HaroldMurcia/Line_Follower/data/slides.pdf

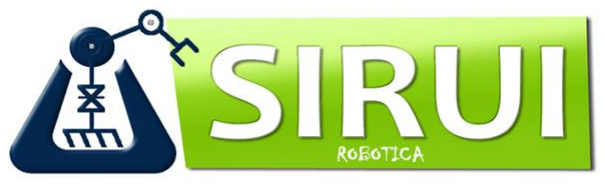
[picture p1: figure]

# DISEÑO E IMPLEMENTACIÓN DE UN ROBOT SEGUIDOR DE LÍNEA DE COMPETENCIA PARA LA CATEGORÍA VELOCISTA

# Autor: Yeison D TAPIERO Director: Harold F MURCIA

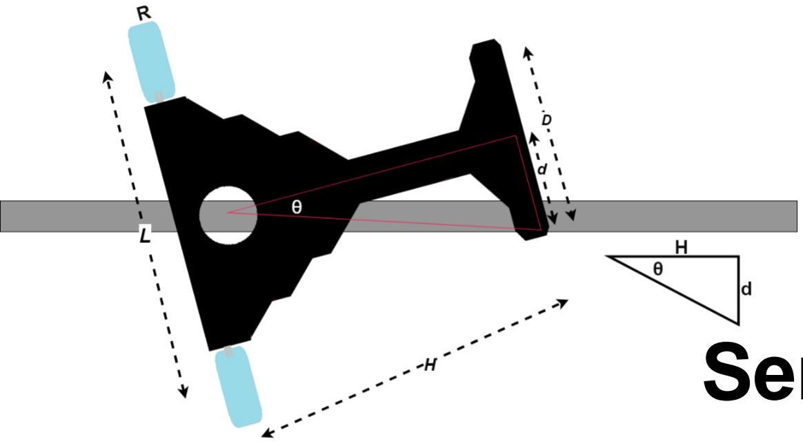
[picture p2: figure]

# Semillero de Investigación: SIRUI Fecha: 15 de Julio de 2019

# Introducción

1

2

3

4

### Planteamiento del Problema

### Objetivos

### Metodología

### Desarrollo

### 5 Resultados

6

### Conclusiones y Trabajo Futuro

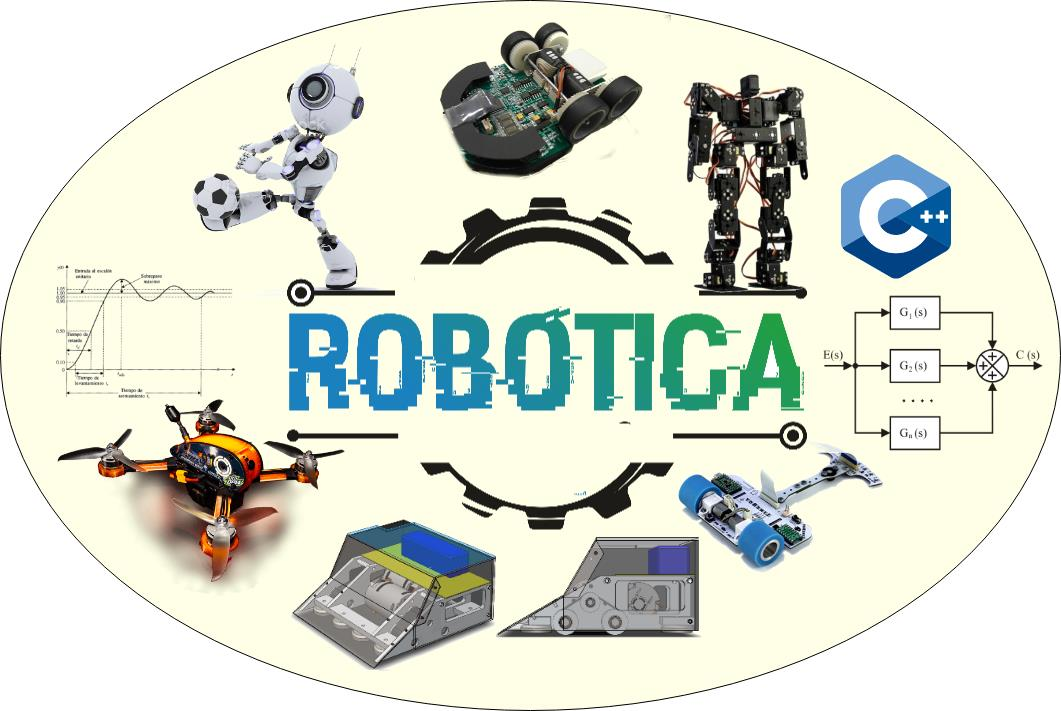
[picture p3: figure]

### La robótica móvil es una de las ramas de la ingeniería que mas avances ha presentado

en | las | últimas | décadas. | Nuevas

### configuraciones mecánicas, estructuras de

control | y | navegación, | desarrollos | en
vehículos | no | tripulados | y | nuevas

### aplicaciones han cambiado la forma en que

conocíamos los sistemas robóticos.

# Planteamiento del Problema

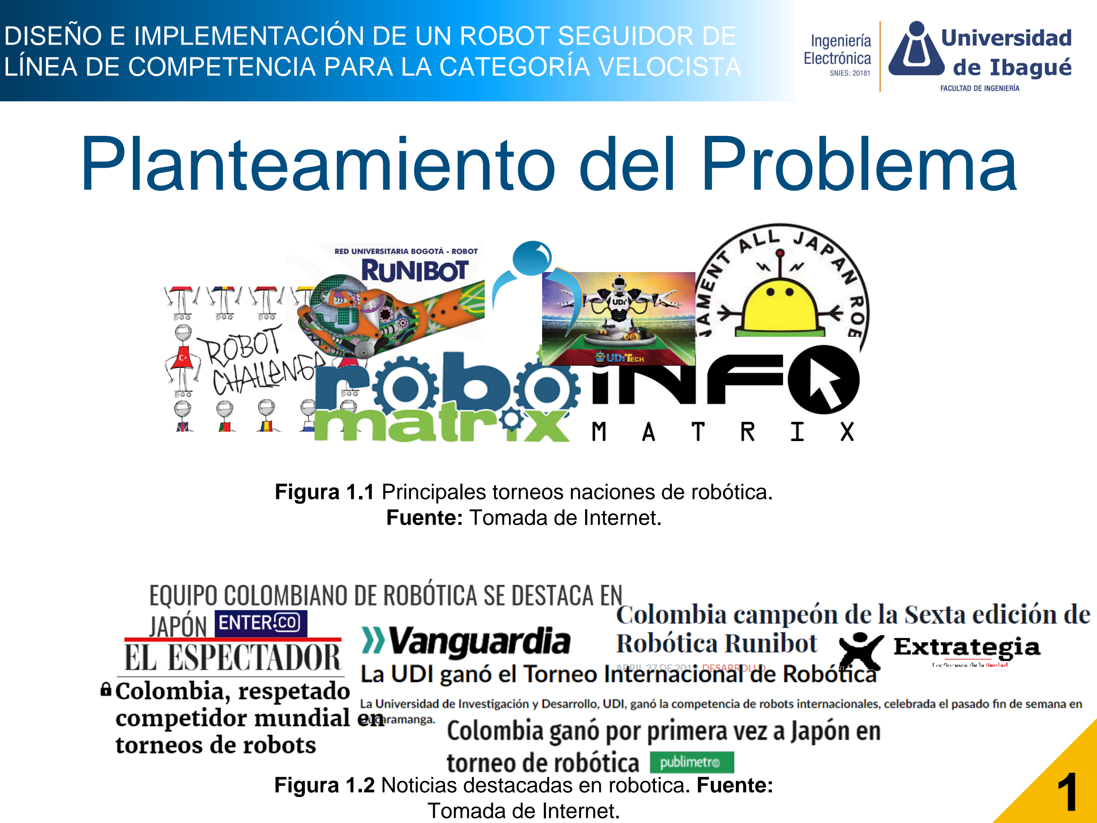
[picture p4: page 3]

1

### DISEÑO E IMPLEMENTACIÓN DE UN ROBOT SEGUIDOR DE LÍNEA DE COMPETENCIA PARA LA CATEGORÍA VELOCISTA

Figura 1.1 Principales torneos naciones de robótica. Fuente: Tomada de Internet.

Figura 1.2 Noticias destacadas en robotica. Fuente: Tomada de Internet.

# Planteamiento del Problema

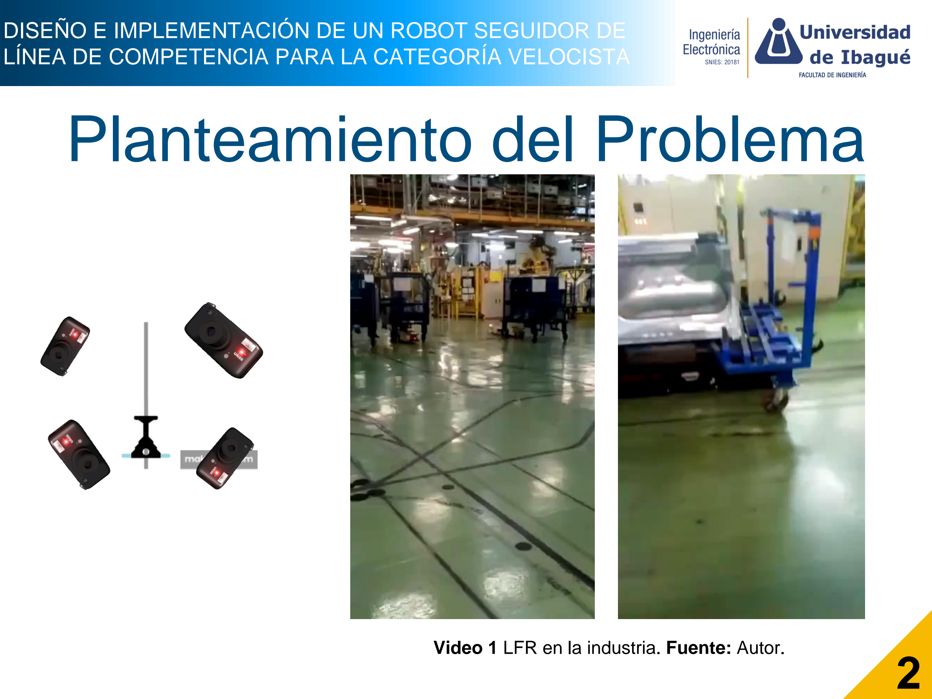
[picture p5: page 4]

2

### LÍNEA DE COMPETENCIA PARA LA CATEGORÍA VELOCISTA

Video 1 LFR en la industria. Fuente: Autor.

# Planteamiento del Problema

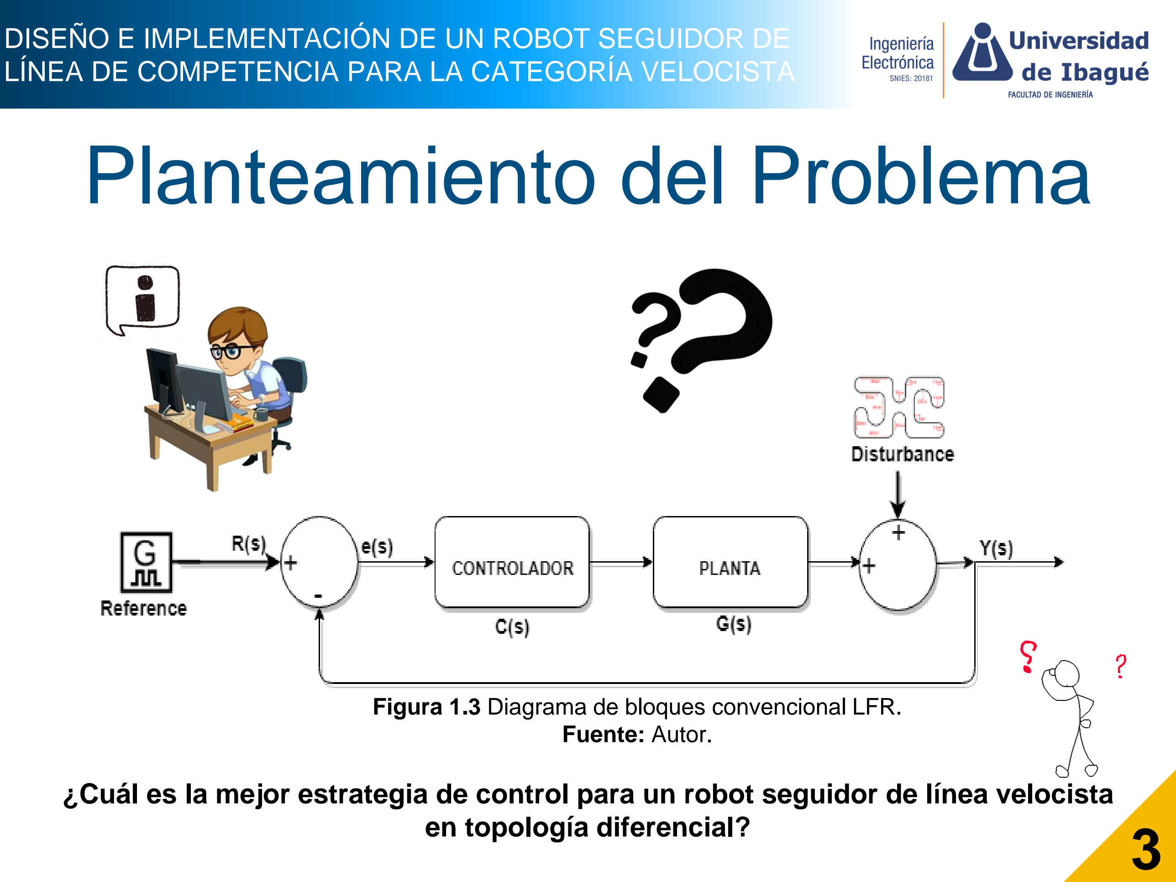
[picture p6: page 5]

3

### LÍNEA DE COMPETENCIA PARA LA CATEGORÍA VELOCISTA

### ¿Cuál es la mejor estrategia de control para un robot seguidor de línea velocista en topología diferencial?

Figura 1.3 Diagrama de bloques convencional LFR. Fuente: Autor.

# Objetivos

### Esta propuesta de proyecto tiene como principal objetivo diseñar, construir y modelar un robot Seguidor de línea para la categoría velocista, con características técnicas de nivel avanzado, que cumplan con los estándares de las

competencias internacionales.

# Objetivo General

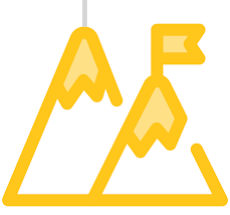
[picture p7: figure]

### - Diseñar e implementar las capas mecánica y electrónica

de un (1) robot seguidor de línea.

### - Obtener un modelo matemático simple que describa la

cinemática y dinámica de un robot seguidor de línea.

### - Diseñar, implementar y comparar tres (3) estrategias de

### control para establecer el robot seguidor de línea en la

trayectoria de referencia. .

# Objetivos Específicos

4

### LÍNEA DE COMPETENCIA PARA LA CATEGORÍA VELOCISTA

# Metodología

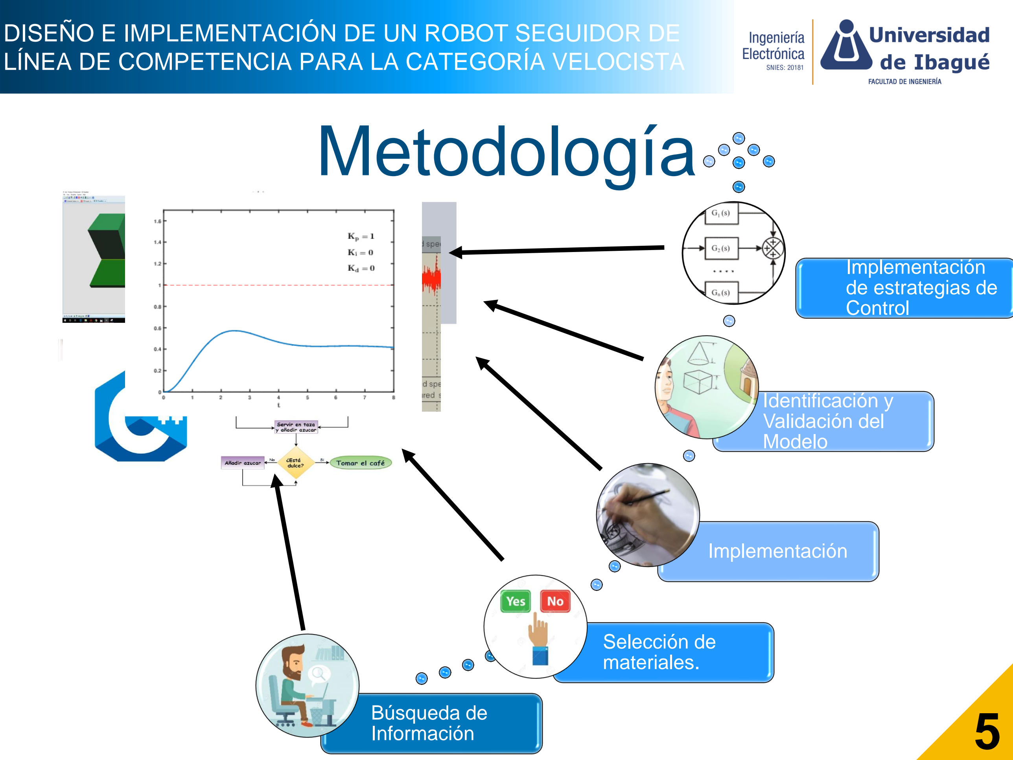
[picture p8: page 7]

5

Búsqueda de
Información

Selección de
materiales.

Implementación

Identificación y
Validación del
Modelo

Implementación
de estrategias de
Control

### LÍNEA DE COMPETENCIA PARA LA CATEGORÍA VELOCISTA

# Desarrollo

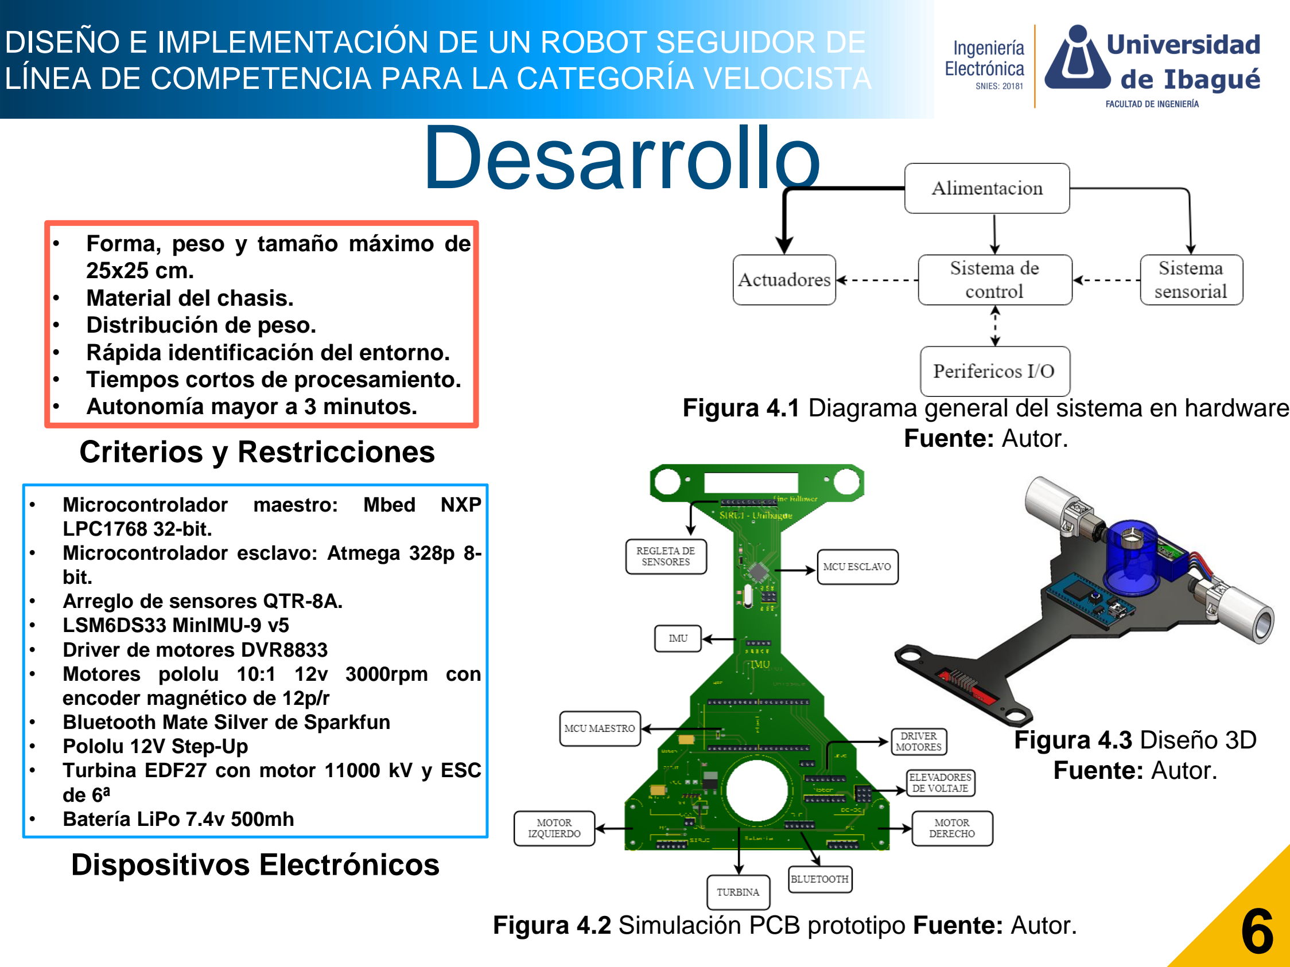
[picture p9: page 8]

6

### LÍNEA DE COMPETENCIA PARA LA CATEGORÍA VELOCISTA

- Forma, peso y tamaño máximo de 25x25 cm.
- Material del chasis.
- Distribución de peso.
- Rápida identificación del entorno.
- Tiempos cortos de procesamiento.
- Autonomía mayor a 3 minutos.

### Criterios y Restricciones

- | Microcontrolador | maestro: | Mbed | NXP
| LPC1768 32-bit.
- Microcontrolador esclavo: Atmega 328p 8-
| bit.
- Arreglo de sensores QTR-8A.
- LSM6DS33 MinIMU-9 v5
- Driver de motores DVR8833
- Motores pololu 10:1 12v 3000rpm con encoder magnético de 12p/r
- Bluetooth Mate Silver de Sparkfun
- Pololu 12V Step-Up
- Turbina EDF27 con motor 11000 kV y ESC
| de 6ª
- Batería LiPo 7.4v 500mh

### Dispositivos Electrónicos

Figura 4.1 Diagrama general del sistema en hardware Fuente: Autor.

Figura 4.2 Simulación PCB prototipo Fuente: Autor.

Figura 4.3 Diseño 3D
Fuente: Autor.

# PERCEPCIÓN

7

### LÍNEA DE COMPETENCIA PARA LA CATEGORÍA VELOCISTA

S =

m − mmin

mmax − mmin

∗ 1000

DS[pሿ =

σi=1

n S pi pi

σi=1

n S pi

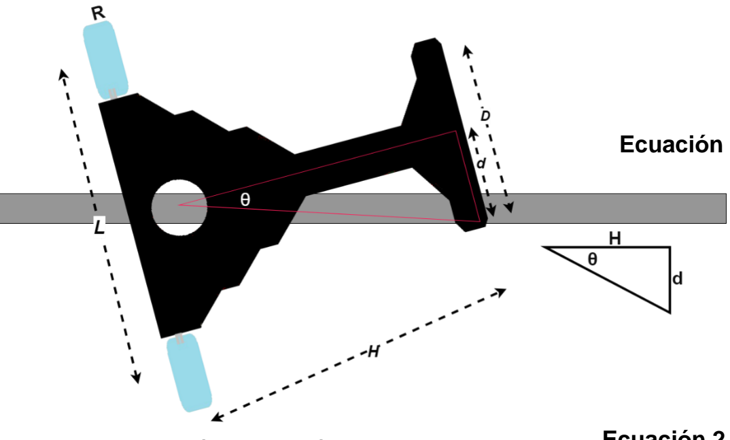
[picture p10: figure]

Figura 4.4 Análisis geométrico de un LFR Fuente: Autor.

Ecuación 1. Normalización de valores proveniente de un sensor IR.

Ecuación 2. Cálculo de posición con respecto a línea.

# PERCEPCIÓN

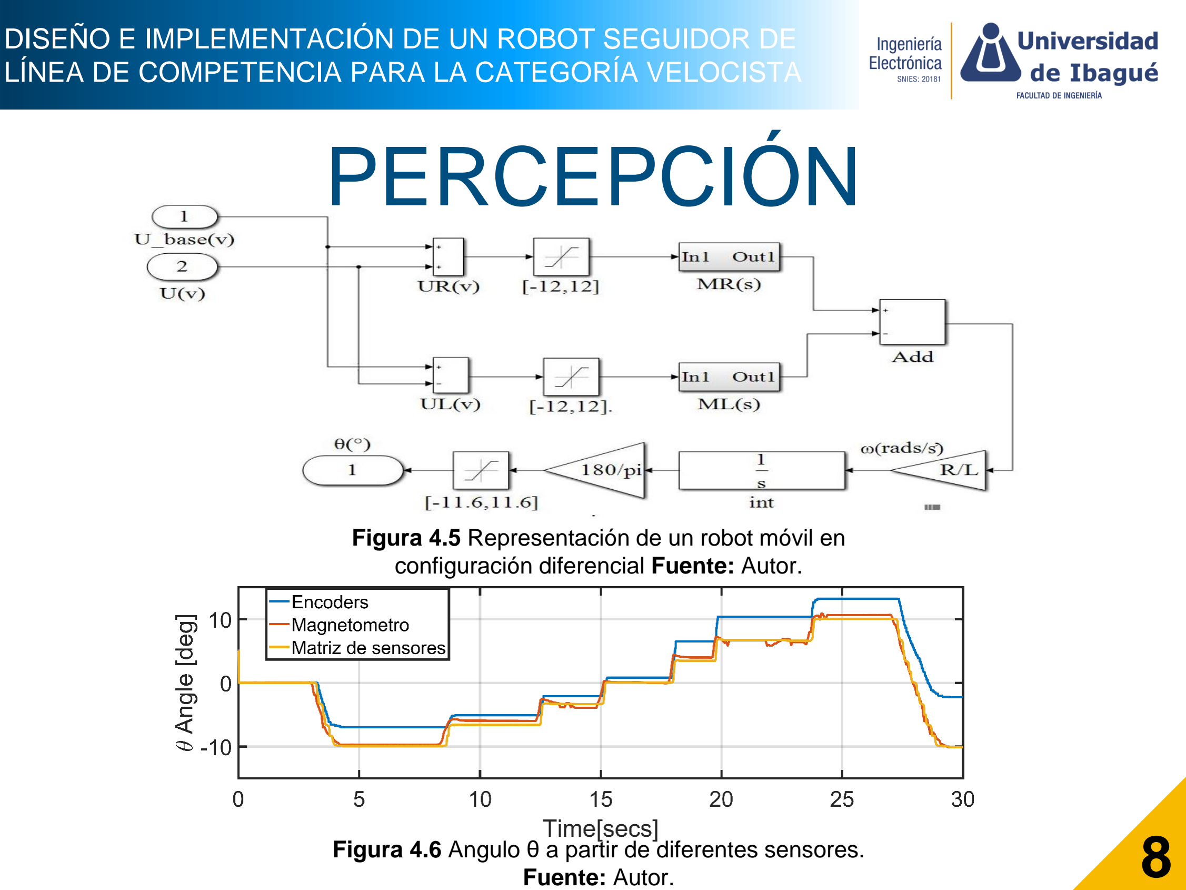
[picture p11: page 10]

8

### LÍNEA DE COMPETENCIA PARA LA CATEGORÍA VELOCISTA

Figura 4.5 Representación de un robot móvil en configuración diferencial Fuente: Autor.

Figura 4.6 Angulo θ a partir de diferentes sensores. Fuente: Autor.

# ESTRATEGIAS DE CONTROL

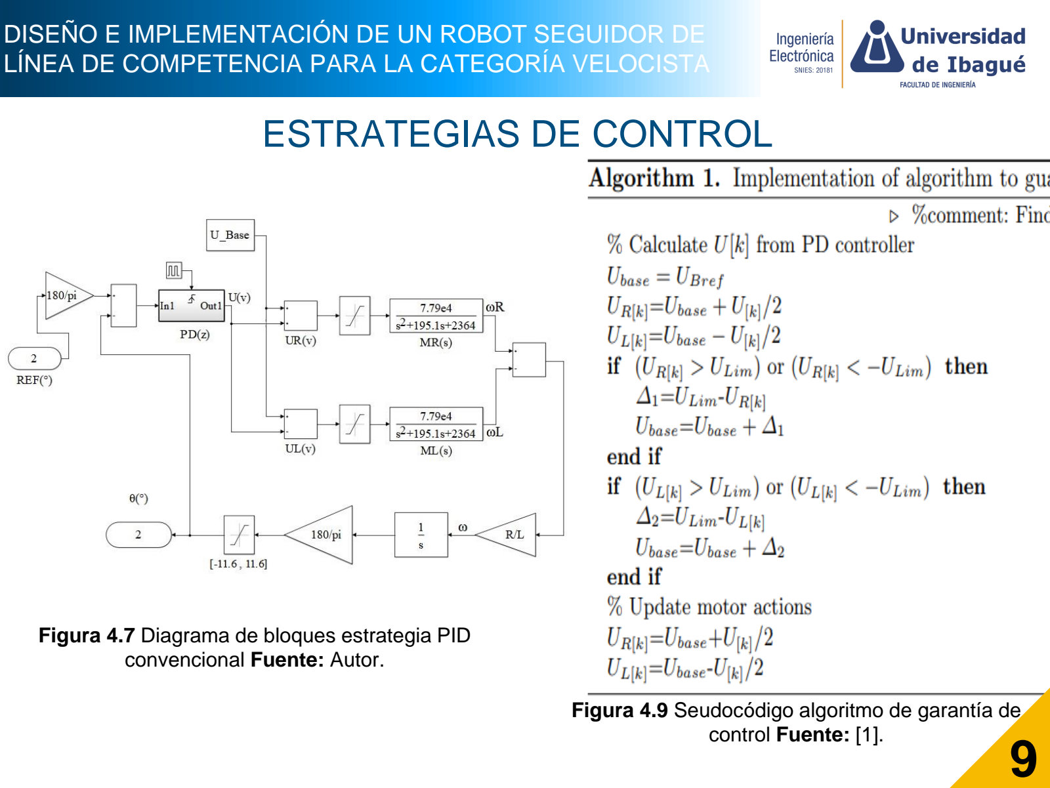
[picture p12: page 11]

9

### LÍNEA DE COMPETENCIA PARA LA CATEGORÍA VELOCISTA

Figura 4.7 Diagrama de bloques estrategia PID convencional Fuente: Autor.

Figura 4.9 Seudocódigo algoritmo de garantía de control Fuente: [1].

# ESTRATEGIAS DE CONTROL

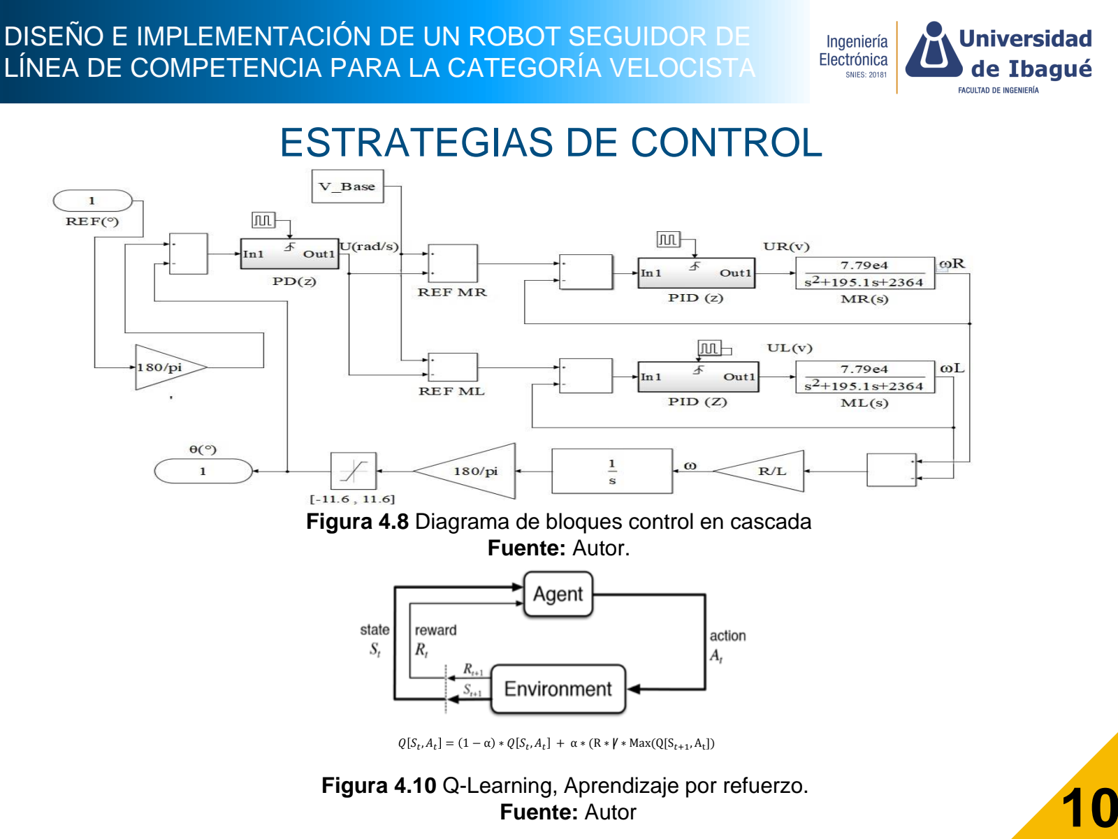
[picture p13: page 12]

10

### LÍNEA DE COMPETENCIA PARA LA CATEGORÍA VELOCISTA

Figura 4.8 Diagrama de bloques control en cascada Fuente: Autor.

Figura 4.10 Q-Learning, Aprendizaje por refuerzo. Fuente: Autor

Q | St
,At | = 1 − α ∗ Q | St
,At | + α ∗ (R ∗ Ꝩ ∗ Max(Q[St+1,At

ሿ)

# IDENTIFICACION DE PARAMETROS

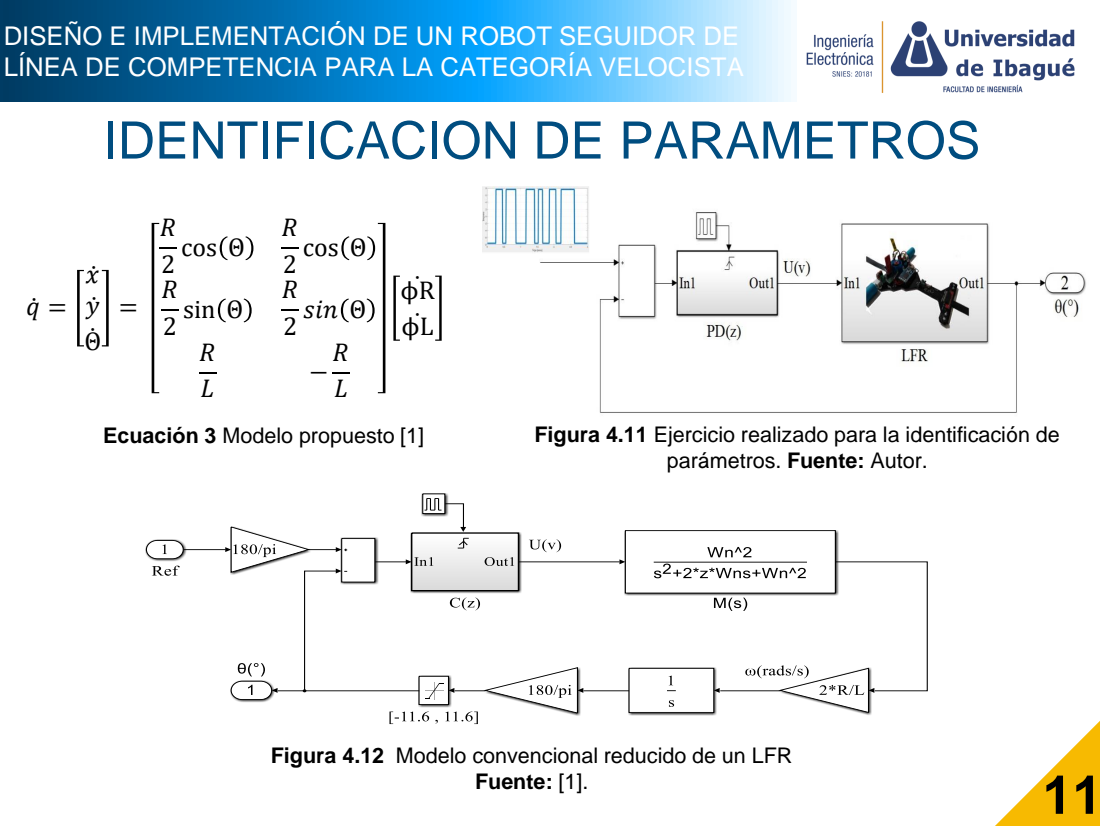
[picture p14: page 13]
cos Θ; sin Θ; ϕRሶ ϕLሶ; Fuente: [1].

LÍNEA DE COMPETENCIA PARA LA CATEGORÍA VELOCISTA

Ecuación 3 Modelo propuesto [1]

Figura 4.11 Ejercicio realizado para la identificación de

parámetros. Fuente: Autor.

Figura 4.12 Modelo convencional reducido de un LFR

# IDENTIFICACION DE PARAMETROS

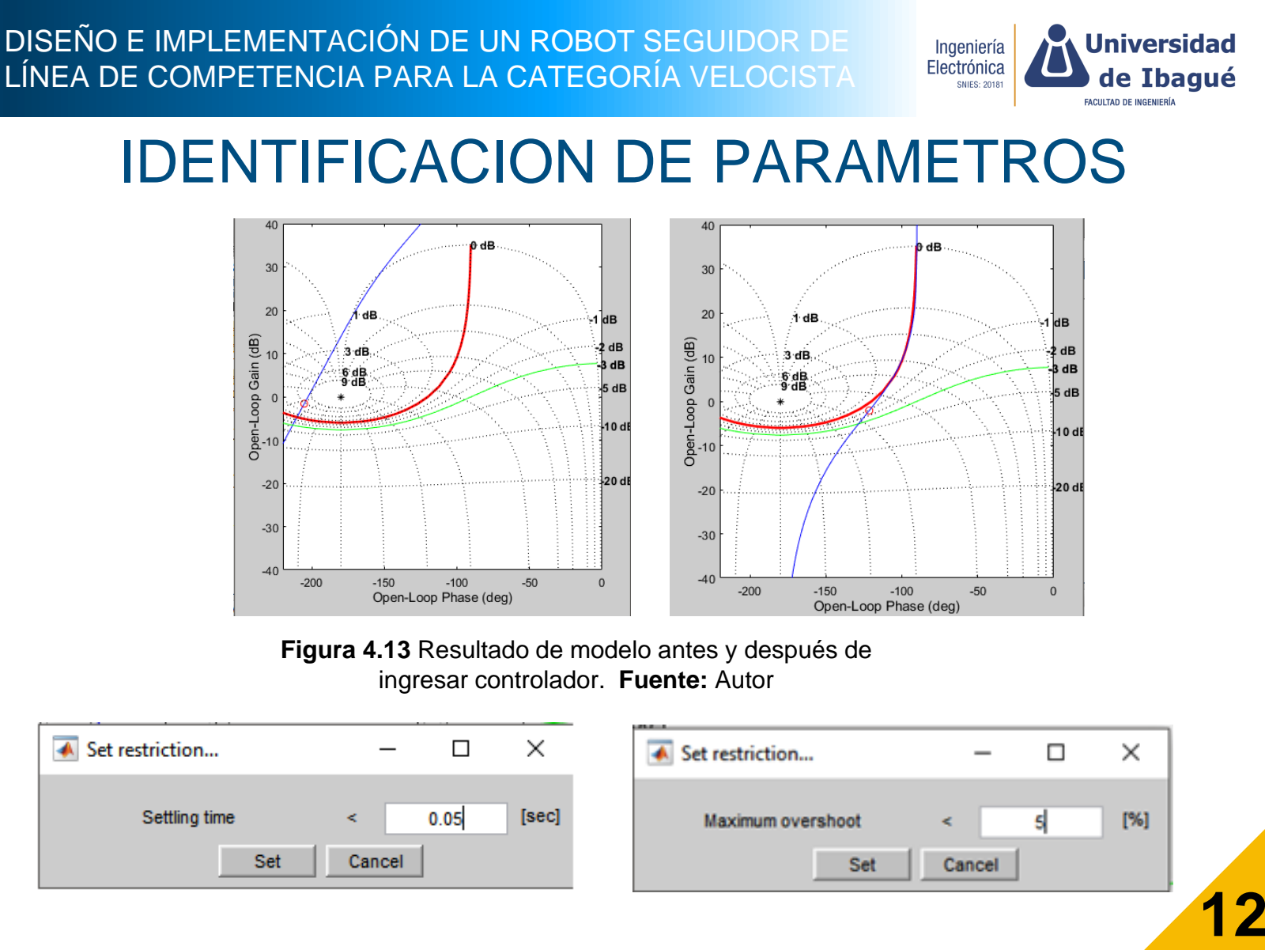
[picture p15: page 14]

12

### LÍNEA DE COMPETENCIA PARA LA CATEGORÍA VELOCISTA

Figura 4.13 Resultado de modelo antes y después de ingresar controlador. Fuente: Autor

# Resultados

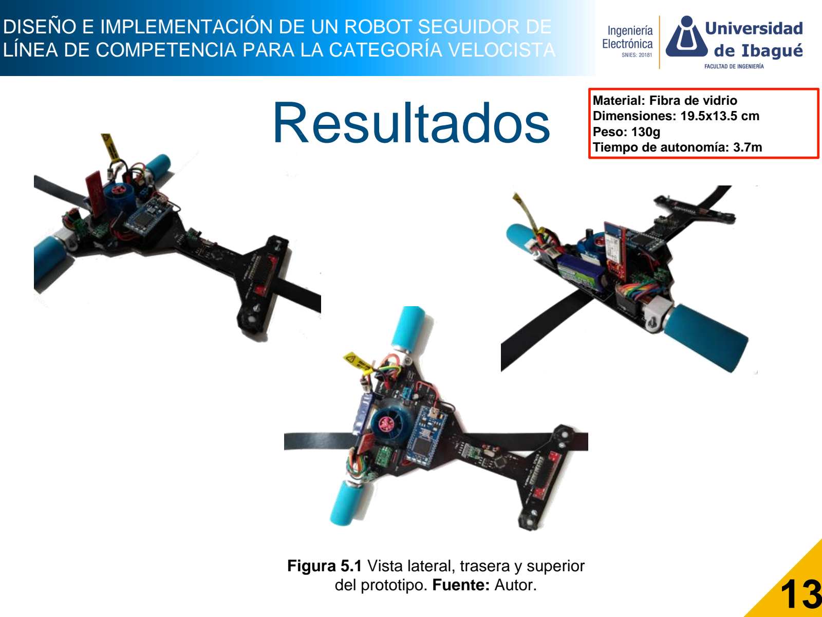
[picture p16: page 15]

13

### LÍNEA DE COMPETENCIA PARA LA CATEGORÍA VELOCISTA

Figura 5.1 Vista lateral, trasera y superior del prototipo. Fuente: Autor.

Material: Fibra de vidrio
Dimensiones: 19.5x13.5 cm
Peso: 130g
Tiempo de autonomía: 3.7m

# Resultados

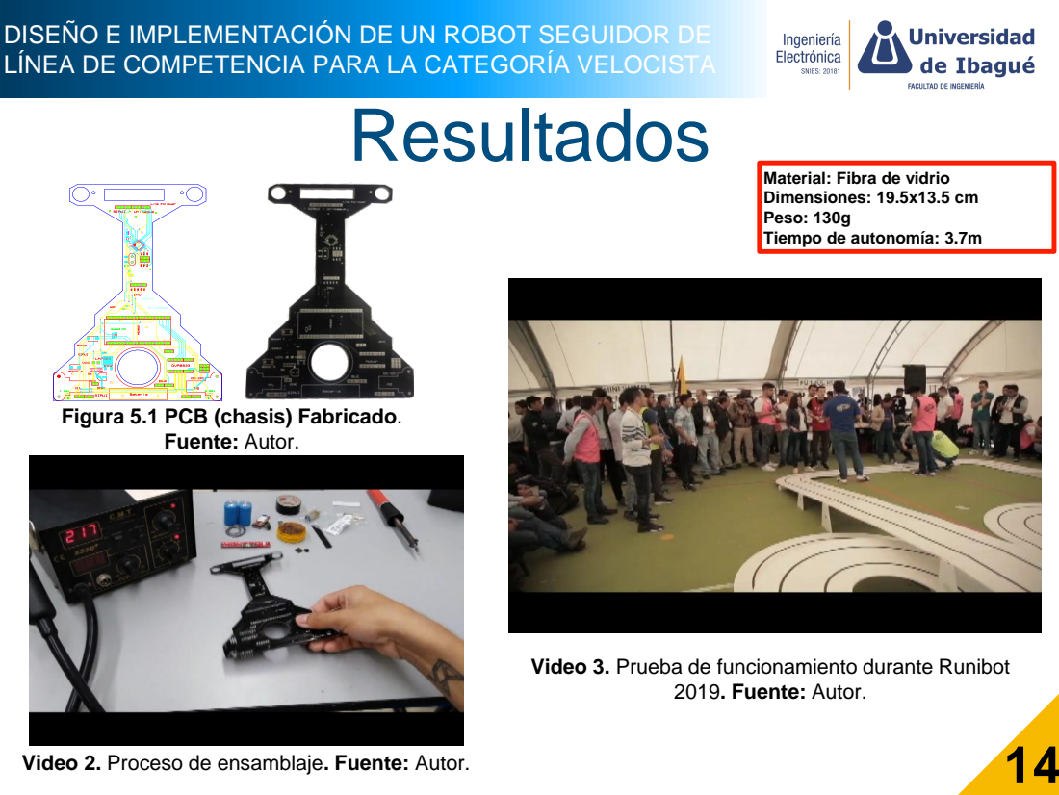
[picture p17: page 16]
Fuente: Autor.; 2019. Fuente: Autor.

LÍNEA DE COMPETENCIA PARA LA CATEGORÍA VELOCISTA

Material: Fibra de vidrio
Dimensiones: 19.5x13.5 cm
Peso: 130g
Tiempo de autonomía: 3.7m

Figura 5.1 PCB (chasis) Fabricado.

Video 3. Prueba de funcionamiento durante Runibot

Video 2. Proceso de ensamblaje. Fuente: Autor.

# Resultados

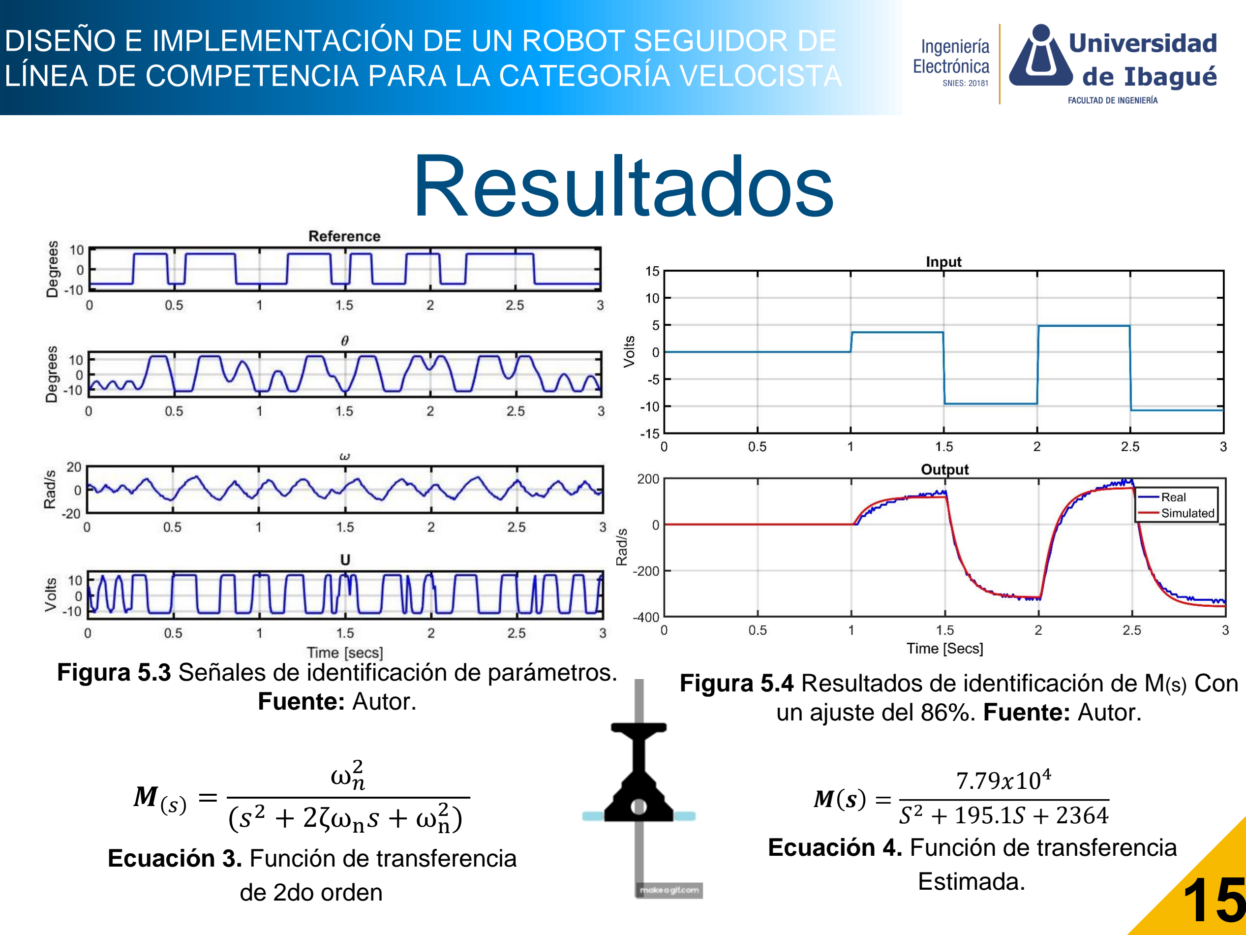
[picture p18: page 17]

15

### LÍNEA DE COMPETENCIA PARA LA CATEGORÍA VELOCISTA

M s =

ωn

2
(s

### 2 + 2ζωns + ωn

2
)

M s =

7.79x10⁴
S

2 + 195.1S + 2364

Figura 5.3 Señales de identificación de parámetros. Fuente: Autor.

Figura 5.4 Resultados de identificación de M(s) Con un ajuste del 86%. Fuente: Autor.

Ecuación 3. Función de transferencia de 2do orden

Ecuación 4. Función de transferencia Estimada.

# Resultados

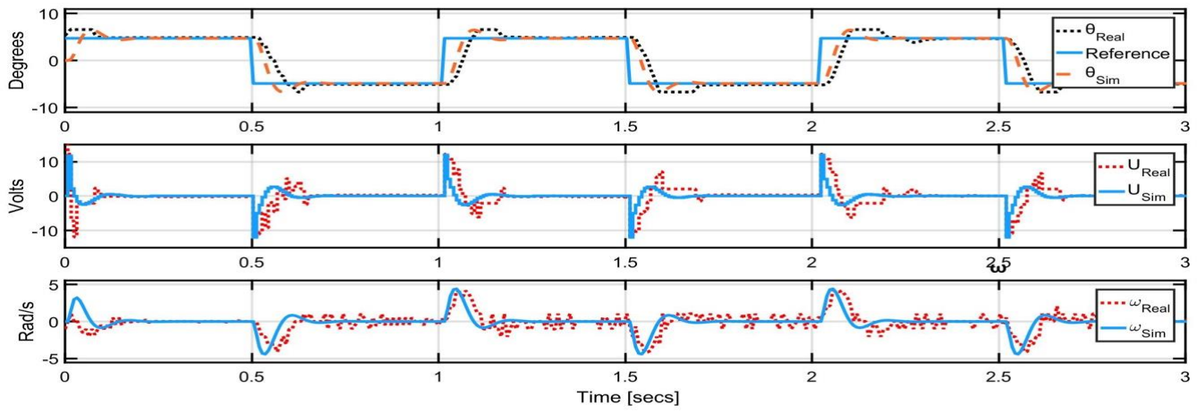
[picture p19: figure]

16

### LÍNEA DE COMPETENCIA PARA LA CATEGORÍA VELOCISTA

G s =

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
s ∗ (s

2 + 2ζωns + ωn

2
)

### KP=0.1083 KD= 0.1125 G s =

2.2954x10⁶

### s s + 182.1 (s + 12.98)

Ecuación 5. Función de transferencia Del sistema.

| Ecuación 6. Función de transferencia
Del sistema estimada.

Figura 5.5 Validación del modelo convencional. Fuente: Autor.

# Resultados

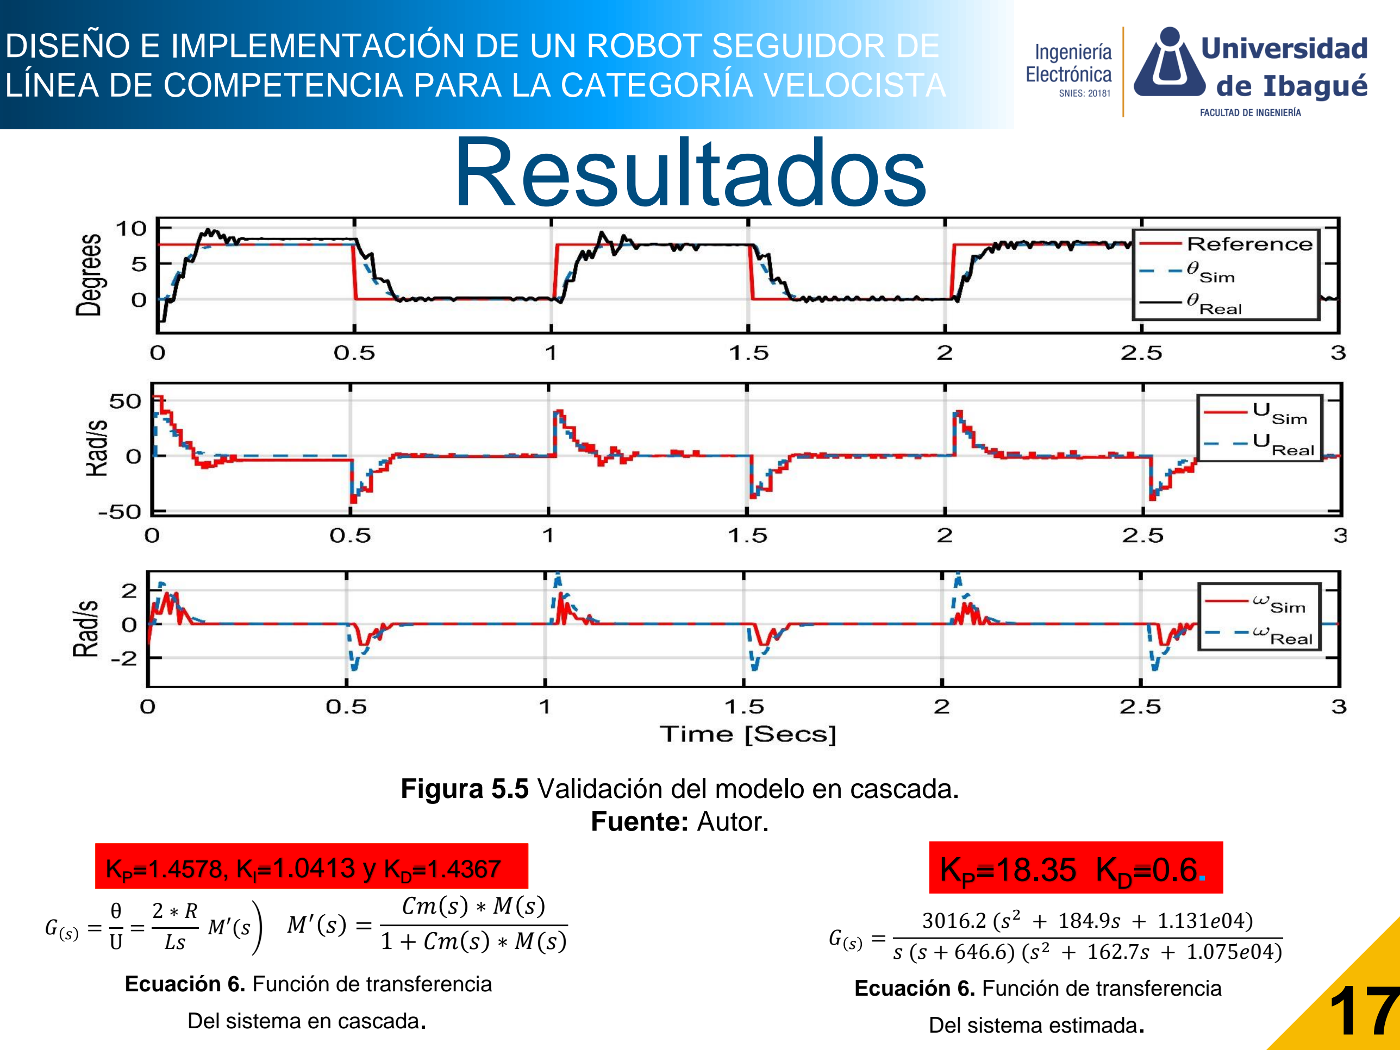
[picture p20: page 19]

17

### LÍNEA DE COMPETENCIA PARA LA CATEGORÍA VELOCISTA

KP=1.4578, KI=1.0413 y KD=1.4367

M′
s =

Cm s ∗ M s
1 + Cm s ∗ M(s)
G s = | ቇ
θ
U

=

2 ∗ R
Ls M′(s | G s =
3016.2 (s | )

2 + 184.9s + 1.131e04
s (s + 646.6) (s | )

2 + 162.7s + 1.075e04

KP=18.35 KD=0.6.

Ecuación 6. Función de transferencia
Del sistema estimada.

Ecuación 6. Función de transferencia Del sistema en cascada.

Figura 5.5 Validación del modelo en cascada. Fuente: Autor.

# Resultados

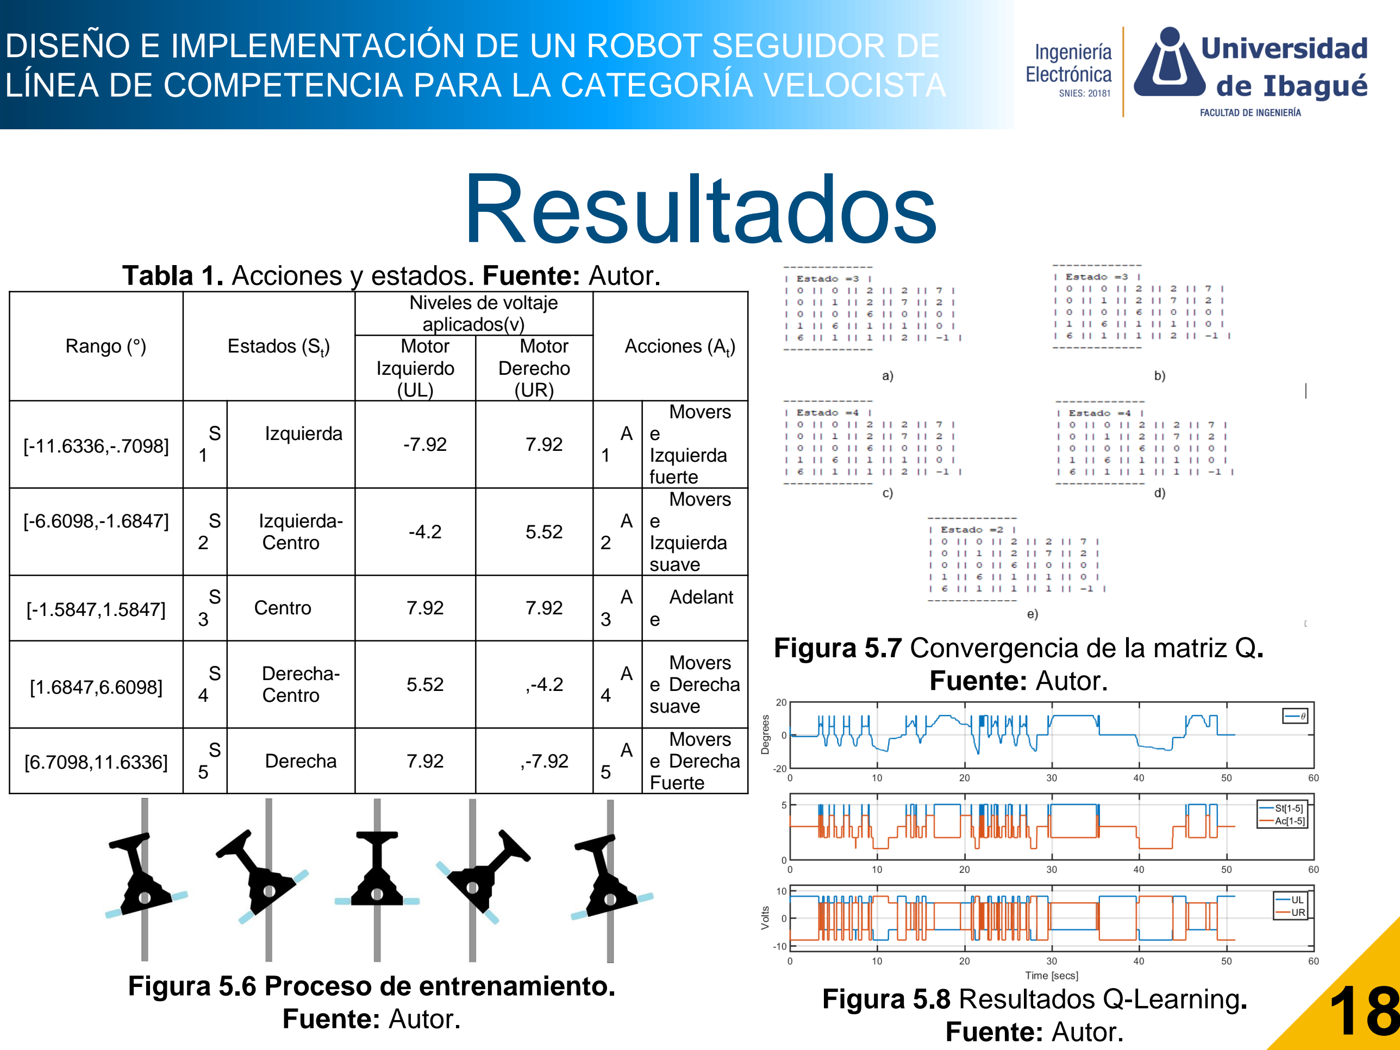
[picture p21: page 20]

18

### LÍNEA DE COMPETENCIA PARA LA CATEGORÍA VELOCISTA

Rango (°) | Estados (St ) | Niveles de voltaje aplicados(v) | )
Izquierdo (UL) | Motor Derecho (UR) | Acciones (At Motor
[-11.6336,-.7098] | S 1 | Izquierda | -7.92 | 7.92 | A 1 | Movers e Izquierda fuerte
[-6.6098,-1.6847] | S 2 | Izquierda-Centro | -4.2 | 5.52 | A 2 | Movers e Izquierda suave
[-1.5847,1.5847] | S 3 | Centro | 7.92 | 7.92 | A 3 | Adelant e
[1.6847,6.6098] | S 4 | Derecha-Centro | 5.52 | ,-4.2 | A 4 | Movers e Derecha suave
[6.7098,11.6336] | S 5 | Derecha | 7.92 | ,-7.92 | A 5 | Movers e Derecha Fuerte

Tabla 1. Acciones y estados. Fuente: Autor.

Figura 5.7 Convergencia de la matriz Q. Fuente: Autor.

Figura 5.6 Proceso de entrenamiento. Fuente: Autor.

Figura 5.8 Resultados Q-Learning. Fuente: Autor.

# Resultados

19

### LÍNEA DE COMPETENCIA PARA LA CATEGORÍA VELOCISTA

Resultados
Controlador | Base | STD (deg) | RMSE (deg) | Lap Time (s)
PID Simple | 12v | ~ | ~ | inf
| 8.4v | ~ | ~ | inf
| 6v | 4.04 | 4.20 | 7.47
| 3,6v | 2.51 | 2.51 | 28.37
PID con garantía de control | 12v | 4.43 | 5.03 | 4.64
| 8.4v | 4.62 | 4.76 | 5.68
| 6v | 4.25 | 4.41 | 7
| 3,6v | 2.76 | 2.77 | 17.85
Control en cascada | 250rad/s | 4,81 | 5.19 | 4.23
| 220rad/s | 4.67 | 4.87 | 5.04
| 157rad/s | 3.91 | 4.13 | 6.68
| 94rad/s | 3.05 | 3.20 | 14.3

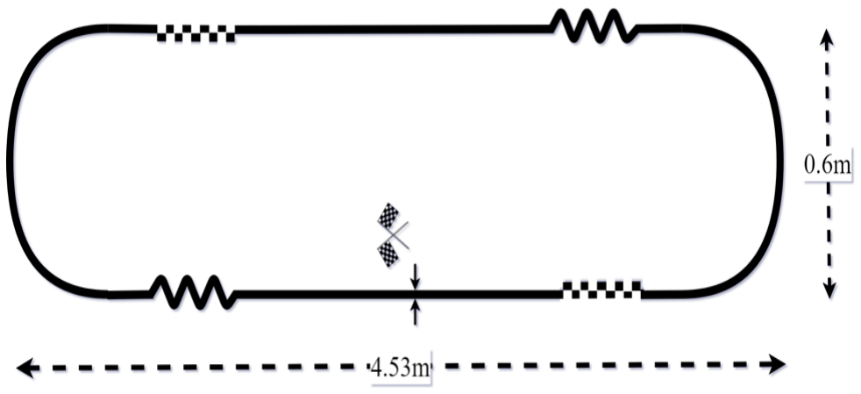
[picture p22: figure]

Figura 5.9 Circuito de pruebas. Fuente: Autor.

Tabla 2. Resultados adquiridos mientras se ponen a prueba las estrategias de control a la velocidad máxima de desplazamiento UBase y Vbase , respectivamente.
Fuente: Autor.

# Resultados

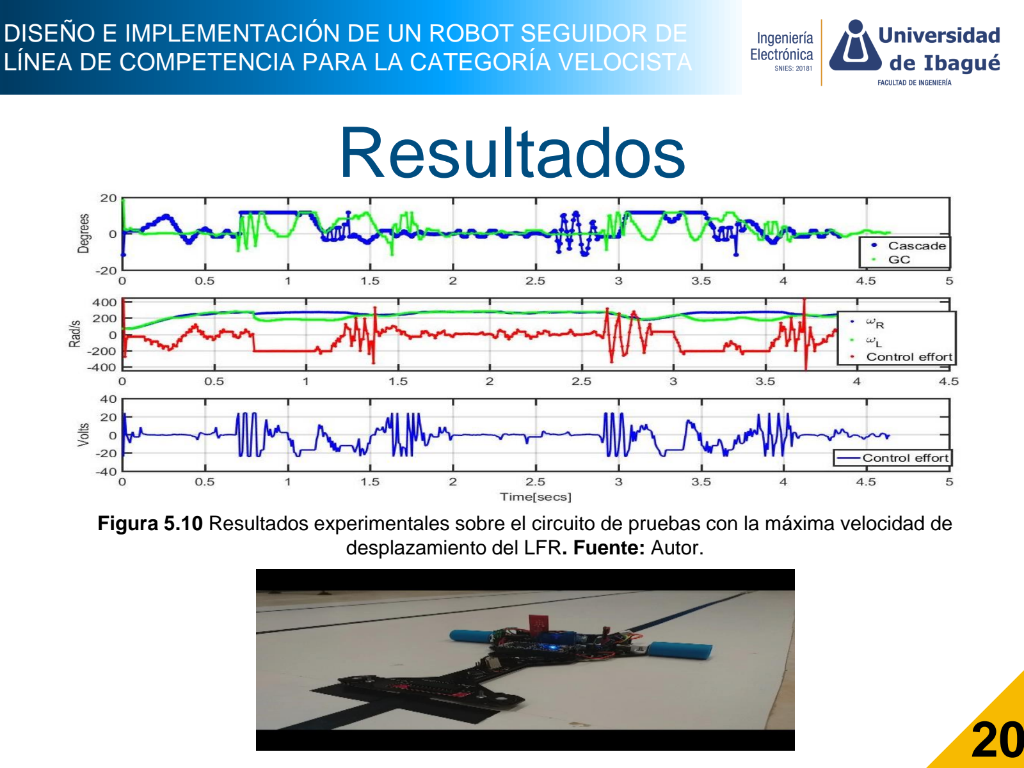
[picture p23: page 22]

20

### LÍNEA DE COMPETENCIA PARA LA CATEGORÍA VELOCISTA

Figura 5.10 Resultados experimentales sobre el circuito de pruebas con la máxima velocidad de desplazamiento del LFR. Fuente: Autor.

# Conclusiones

- La mejor forma de controlar un LFR es a través del sistema en cascada, teniendo en cuenta que fue la alternativa con mejor desempeño tanto en simulación como en su validación experimental, obteniendo el mejor tiempo de pista de 4.23 segundos con indicadores de estabilidad aceptables, respecto a las opciones de PD con garantía de control 4.64 segundos y 7.63 en la arquitectura convencional de control.
- La implementación de un controlador requiere de hardware adicional respecto a las estrategias convencionales, lo cual incrementa la complejidad del software, el peso y costo del robot.
- Actualmente un controlador PD convencional es suficiente para lograr un control optimo de un LFR a altas velocidades, es por esto que muchos desarrolladores añaden rutinas propias adicionales, en busca de optimizar dicho controlador, en este trabajo se propuso el algoritmo de garantía de control como solución a este problema.
- El LFR es un sistema el cual permite implementar diferentes controladores para diferentes puntos de operación, que permitan optimizar los parámetros de estabilidad y velocidad de respuesta.

21

### LÍNEA DE COMPETENCIA PARA LA CATEGORÍA VELOCISTA

# Recomendaciones

22

### LÍNEA DE COMPETENCIA PARA LA CATEGORÍA VELOCISTA

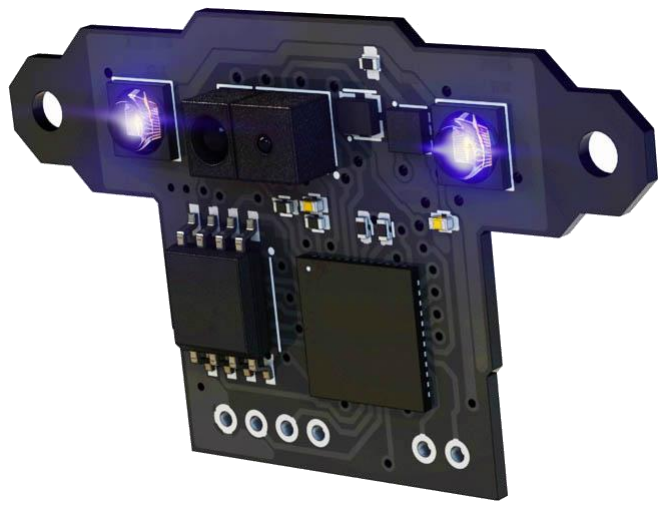
[picture p24: figure]

Figura 6.1 Sistema de visión de alta velocidad de fotogramas. Fuente:
https://hbfsrobotics.com/linefollower.

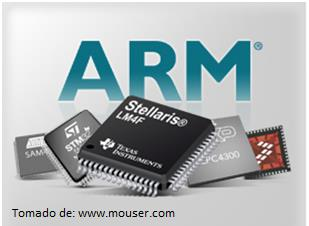
[picture p25: figure]

Figura 6.1 Micrcontroladroes con arquitectrua ARM. Fuente: https://www.arm.com/products/silicon-ip-cpu.

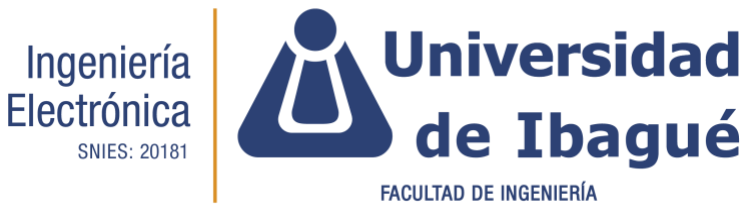
[picture p26: figure]

# Referencias

[1] H. Murcia, J. D. Valenciano, and Y. Tapiero, “Development of a Line-Follower Robot for Robotic Competition Purposes,” Appl. Comput. Sci. Eng., pp. 464–474, Oct. 2018.
[2] Edgar Roberto Ramos., “Modelado, simulación y construcción de un robot móvil de ruedas tipo diferencial,” Latin-American Journal of Physics Education, Ciudad de Mexico, 2010.
[3] H. F. Murcia and A. E. Gonzalez, “Performance comparison between PID and LQR control on a 2-wheel inverted pendulum robot,” in 2016 IEEE Colombian Conference on Robotics and Automation (CCRA), 2016, pp. 1–6.
[4] M. Pakdaman and M. M. Sanaatiyan, “Design and Implementation of Line Follower Robot,” in 2009 Second International Conference on Computer and Electrical Engineering, 2009, pp. 585–590.
[5] S. E. M. Bajestani and A. Vosoughinia, “Technical report of building a line follower robot,” in 2010 International Conference on Electronics and Information Engineering, 2010, pp. V1-1-V1-5.
[6] T. Fukao; H. Nakagawa; N. Adachi, “Adaptive tracking control of a nonholonomic mobile robot,” IEEE Trans. Robot. Autom., vol. 16, pp. 609–605, 2000.

# Aportes

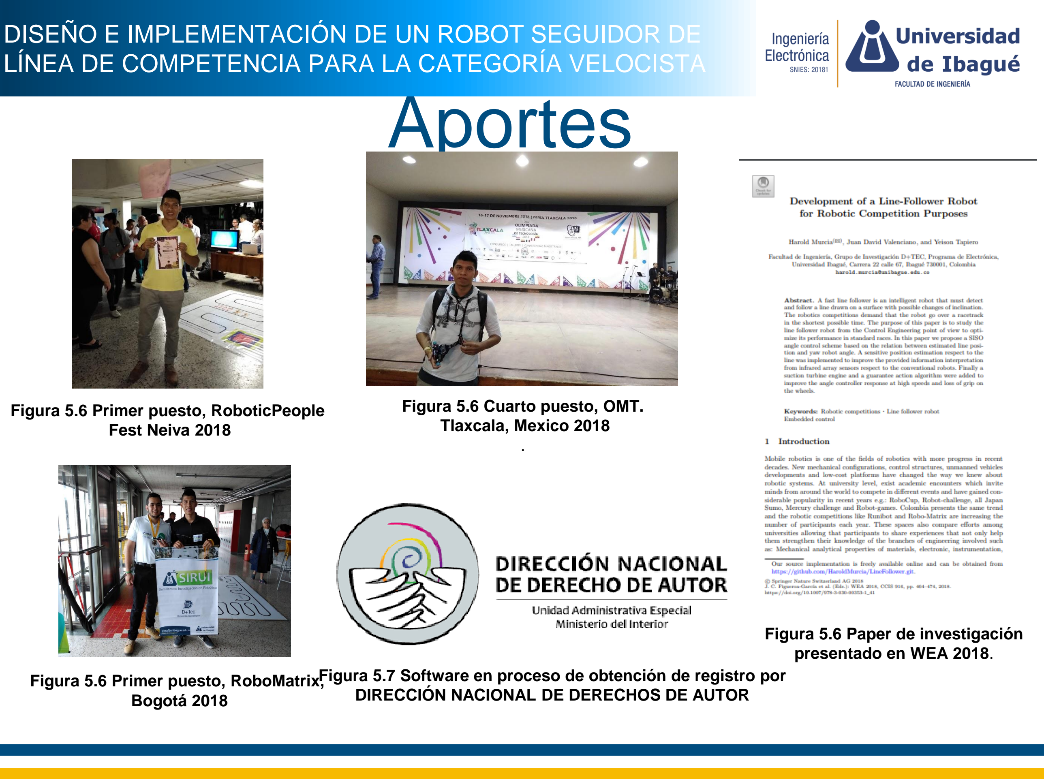
[picture p27: page 26]

### LÍNEA DE COMPETENCIA PARA LA CATEGORÍA VELOCISTA

Figura 5.6 Primer puesto, RoboticPeople Fest Neiva 2018

Figura 5.6 Primer puesto, RoboMatrix, Bogotá 2018

Figura 5.6 Paper de investigación presentado en WEA 2018.

Figura 5.6 Cuarto puesto, OMT. Tlaxcala, Mexico 2018

Figura 5.7 Software en proceso de obtención de registro por DIRECCIÓN NACIONAL DE DERECHOS DE AUTOR

# Aportes

### LÍNEA DE COMPETENCIA PARA LA CATEGORÍA VELOCISTA

Durante el desarrollo de este proyecto, se obtuvieron diferentes resultados y productos, los cuales se presentan a continuación:

Participación en torneos de robótica junto con las muestras estudiantiles de la universidad:

- Torneo RoboMatrix en sus versiones 2016, 2017, 2018 I, 2018 II. Celebrado en la ciudad de Bogotá en la Corporación Universitaria Minuto de Dios y Universidad Piloto de Colombia. Obteniendo el primer lugar en la categoría velocista en las versiones 2018.
- Torneo Runibot en sus versiones 2016,2017,2018. Celebrado en la ciudad de Bogotá en las Universidades Católica, Cooperativa y Corporación Universitaria Minuto de Dios, obteniendo el cuarto puesto en la versión 2018.
- Torneo Robotic People Fest 2017 y 2018. Celebrado en las ciudades de Bogotá en el centro internacional de negocios Corferias y en la ciudad de Neiva en la Universidad Surcolombiana, obteniendo el primer lugar en su versión 2018. Cabe resaltar que durante la participación en el Robotic People Fest 2018, se logró una acreditación para asistir a las Olimpiadas Mexicanas de tecnología en la Ciudad de Tlaxcala, México en ese mismo año, apoyados por el programa de Ingeniería Electrónica de la Universidad de Ibagué.
- Muestra estudiantil del programa de Electrónica de la Universidad de Ibagué en sus versiones 2017B y 2018A. Además de las diferentes representaciones de semilleros del grupo D+TEC y participaciones como jurado en eventos de robótica.

# Aportes

### LÍNEA DE COMPETENCIA PARA LA CATEGORÍA VELOCISTA

Participación en productos y eventos de carácter investigativo:

- Encuentro departamental de semilleros de investigación RedCOLSI nodo Tolima, Universidad Antonio Nariño sede Ibagué, noviembre de 2017.
- Encuentro departamental de semilleros de investigación RedCOLSI nodo Tolima, Universidad San Buenaventura sede Ibagué, marzo de 2018.
- En el ámbito investigativo, se logró la publicación de un artículo bajo el nombre de: Development of a Line-Follower Robot for Robotic Competition Purposes. Presentado en el evento WEA 2018..

Adicionalmente, se deja a disposición, un repositorio donde se encuentran los códigos fuente del proyecto los cuales cuentan con un registro de software con la Universidad de Ibagué en proceso, junto con los diagramas de conexiones y planos de PCB. Además de videos descriptivos que presentan el funcionamiento del robot, disponible en el siguiente enlace: https://github.com/HaroldMurcia/Line_Follower

# Preguntas y Respuestas

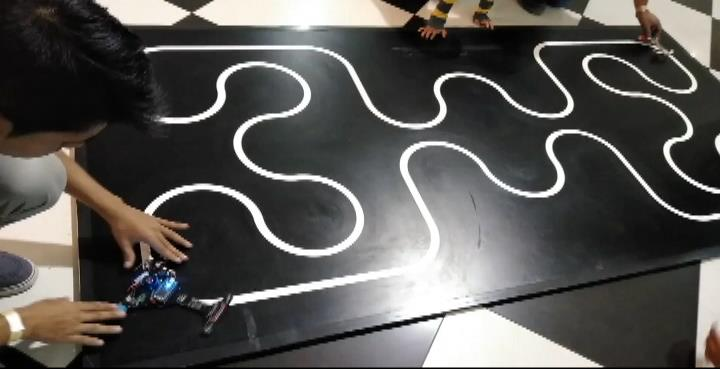
[picture p28: figure]
