HaroldMurcia/Line_Follower/data/PCB/LFR.png

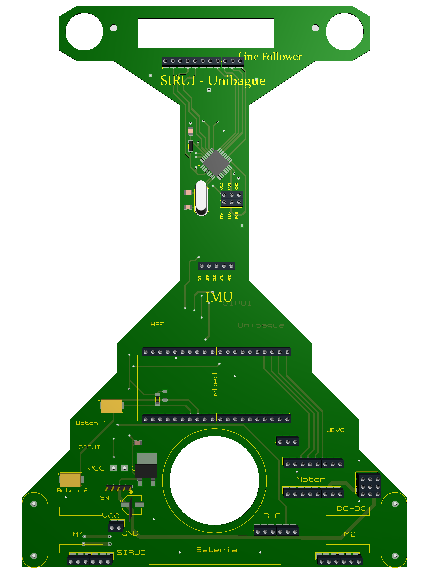
data/PCB/LFR.png
