HaroldMurcia/Line_Follower/(list of files, drawings)

Other design files:
data/PCB/PCB_ares.pdsprj
data/PCB/shematic.pdsprj
